mjc-ermont/2011/README

Git avait dit de faire un README alors j'en ai fait un.
JeanMouloude (@lucas95)

(fallait le modifier pour le commit)

N'oublions pas de dire que la reponse est 42 mon cher Jean !
Je ne sais quoi dire ...
