mjc-ermont/2011/Electronique/Modulation FSK/Liste composants.txt

Resistances :
	- 2 x 5.1K
	- 1 x 200
	- 1 x 50K
	- 2 Resistance de valeur inconnue

Condensateurs :
	- 1 x 10µ Polarisé
	- 2 x 1µ
	- 1 Condensateur de valeur inconnue

- XR2206
