mjc-ermont/2011/Administratif/Schema avion/schema.pdf

## Schéma de l'avion

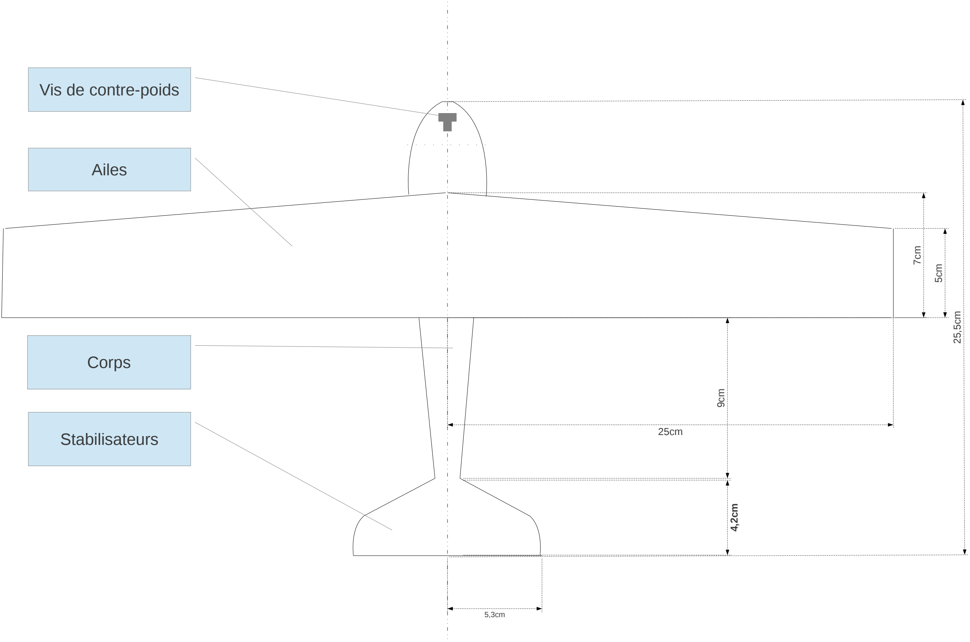
[picture p38: figure]
Vis de contre-poids; Ailes; Stabilisateurs; Corps
