mjc-ermont/2011/Programmation/Codes fonctionnels/Logger21/LSerie/Exemple/serialtest.jpg

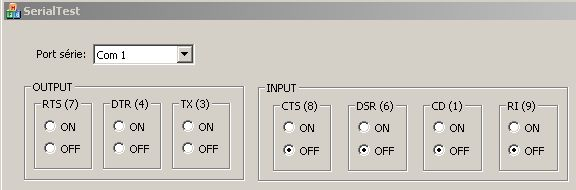
Programmation/Codes fonctionnels/Logger21/LSerie/Exemple/serialtest.jpg
