mjc-ermont/2011/Meca/Modélisation nacelle SolidWorks/Maintient Pile Arduino/Assemblage Pile.SLDASM

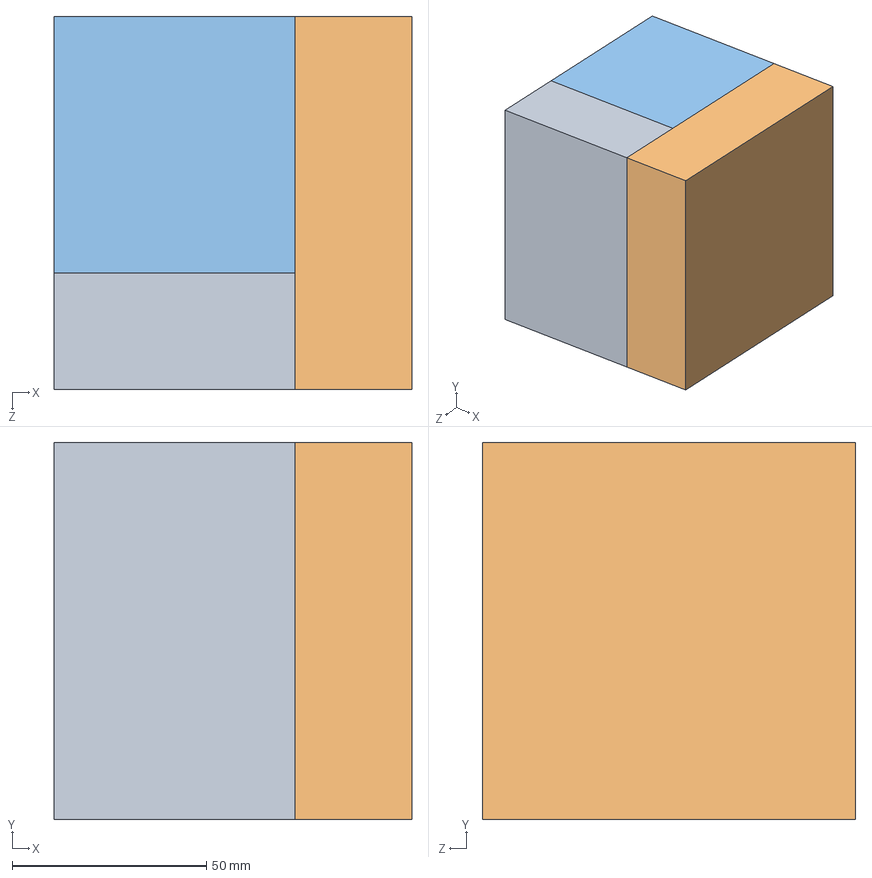
[picture p40: CAD file, 2013-04-06]
Meca/Modélisation nacelle SolidWorks/Maintient Pile Arduino/Assemblage Pile.SLDASM
92.0 x 97.0 x 96.0 mm
Plaque1
Plaque2
Bouchon
