mjc-ermont/2011/Meca/Modélisation nacelle SolidWorks/Assemblage.SLDASM

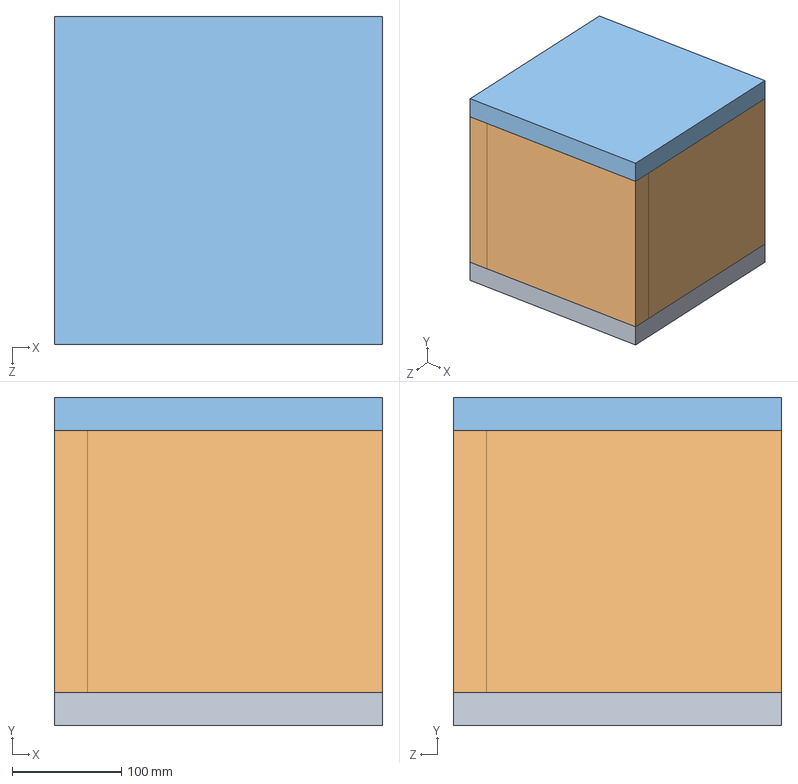
[picture p41: CAD file, 2013-04-07]
Meca/Modélisation nacelle SolidWorks/Assemblage.SLDASM
300.0 x 300.0 x 300.0 mm
Plaque inférieure
Plaque latérale x 4
Plaque supérieure
Plaque1
Plaque2
Bouchon
Arduino
Kiwi
Bouchon_kiwi
Plaque1_kiwi
Plaque2_kiwi
