mjc-ermont/2011/Meca/Modélisation nacelle SolidWorks/Maintient pile kiwi/Assemblage_kiwi.SLDASM

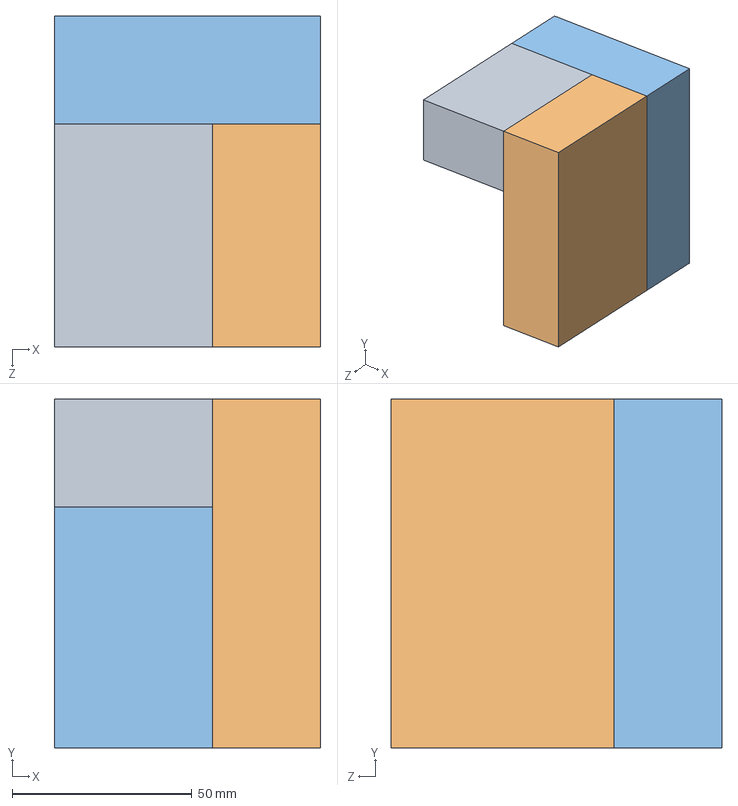
[picture p42: CAD file, 2013-04-06]
Meca/Modélisation nacelle SolidWorks/Maintient pile kiwi/Assemblage_kiwi.SLDASM
74.0 x 97.0 x 92.0 mm
Bouchon_kiwi
Plaque1_kiwi
Plaque2_kiwi
