mjc-ermont/2011/Meca/Modélisation nacelle SolidWorks/Maintient Pile Arduino/Plaque1.SLDPRT

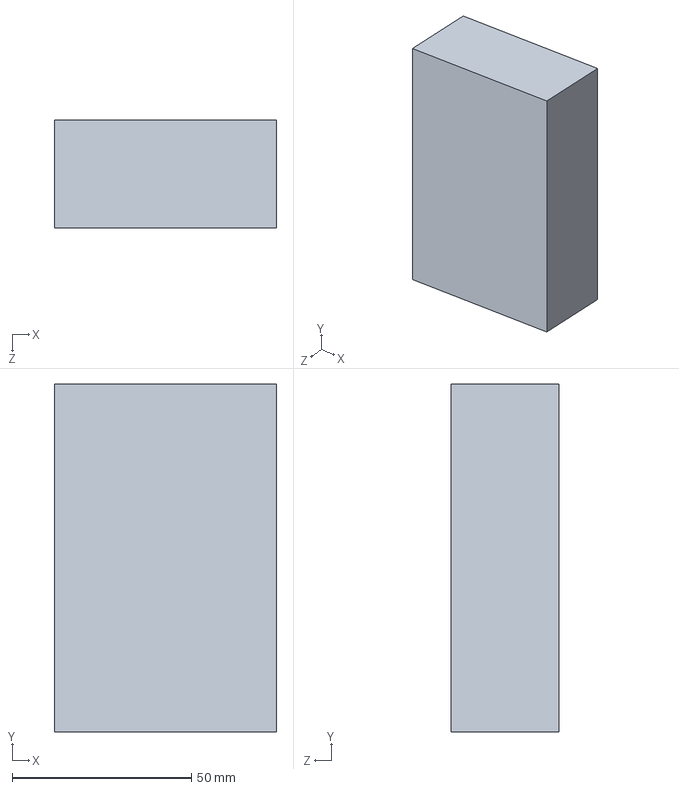
[picture p43: CAD file, 2013-04-06]
Meca/Modélisation nacelle SolidWorks/Maintient Pile Arduino/Plaque1.SLDPRT
62.0 x 97.0 x 30.0 mm
