mjc-ermont/2011/Meca/Modélisation nacelle SolidWorks/Maintient pile kiwi/Plaque2_kiwi.SLDPRT

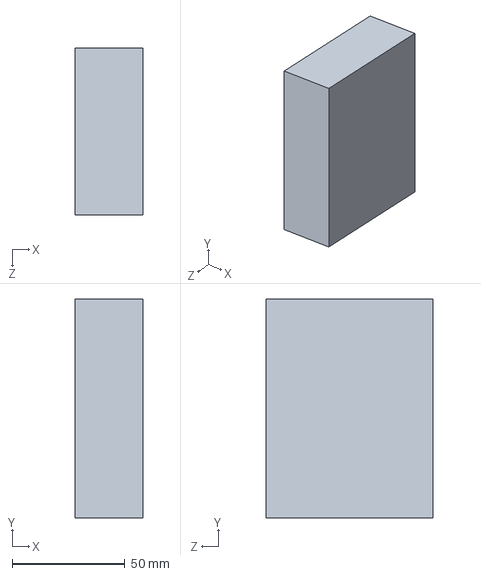
[picture p44: CAD file, 2013-04-06]
Meca/Modélisation nacelle SolidWorks/Maintient pile kiwi/Plaque2_kiwi.SLDPRT
30.0 x 97.0 x 74.0 mm
