mjc-ermont/2011/Meca/Modélisation nacelle SolidWorks/Plaque latérale.SLDPRT

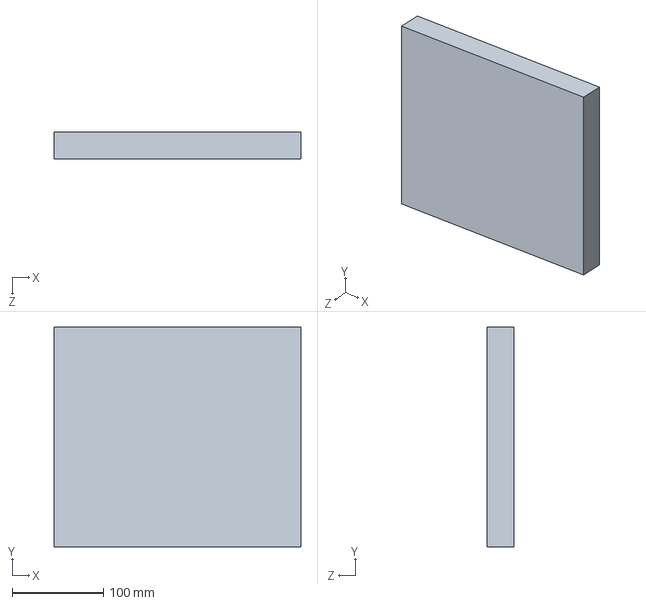
[picture p45: CAD file, 2013-04-07]
Meca/Modélisation nacelle SolidWorks/Plaque latérale.SLDPRT
270.0 x 240.0 x 30.0 mm
