mjc-ermont/2011/Meca/Modélisation nacelle SolidWorks/Maintient pile kiwi/Bouchon_kiwi.SLDPRT

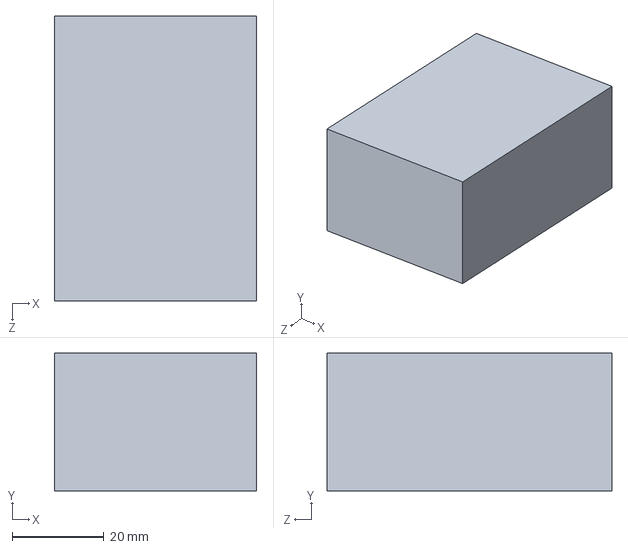
[picture p46: CAD file, 2013-04-06]
Meca/Modélisation nacelle SolidWorks/Maintient pile kiwi/Bouchon_kiwi.SLDPRT
44.0 x 30.0 x 62.0 mm
