mjc-ermont/2011/Meca/Modélisation nacelle SolidWorks/Plaque supérieure.SLDPRT

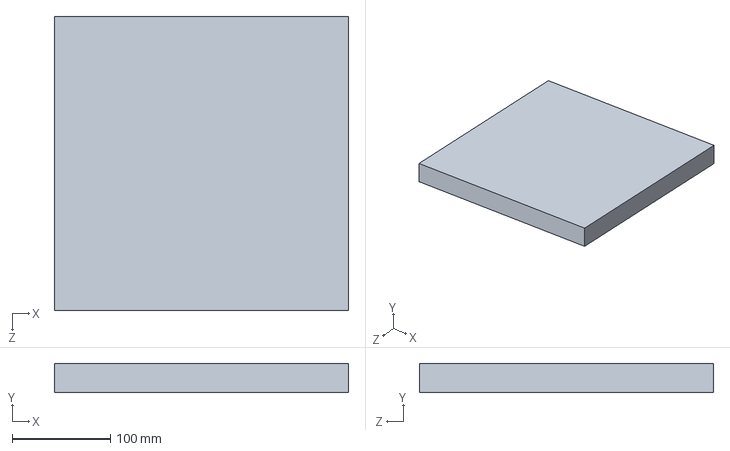
[picture p47: CAD file, 2013-04-07]
Meca/Modélisation nacelle SolidWorks/Plaque supérieure.SLDPRT
300.0 x 30.0 x 300.0 mm
