mjc-ermont/2011/Meca/Modélisation nacelle SolidWorks/Maintient Pile Arduino/Bouchon.SLDPRT

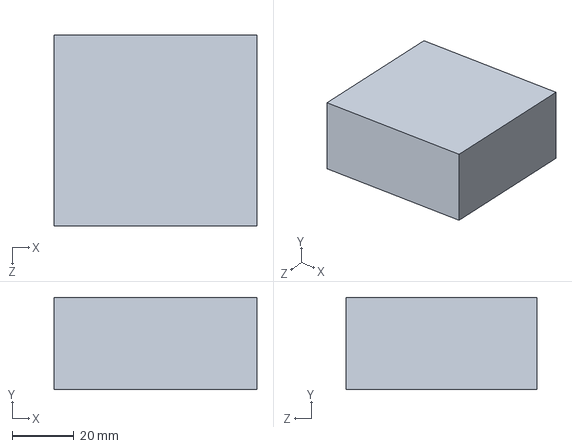
[picture p48: CAD file, 2013-04-06]
Meca/Modélisation nacelle SolidWorks/Maintient Pile Arduino/Bouchon.SLDPRT
66.0 x 30.0 x 62.0 mm
