mjc-ermont/2011/Meca/Modélisation nacelle SolidWorks/Kiwi.SLDPRT

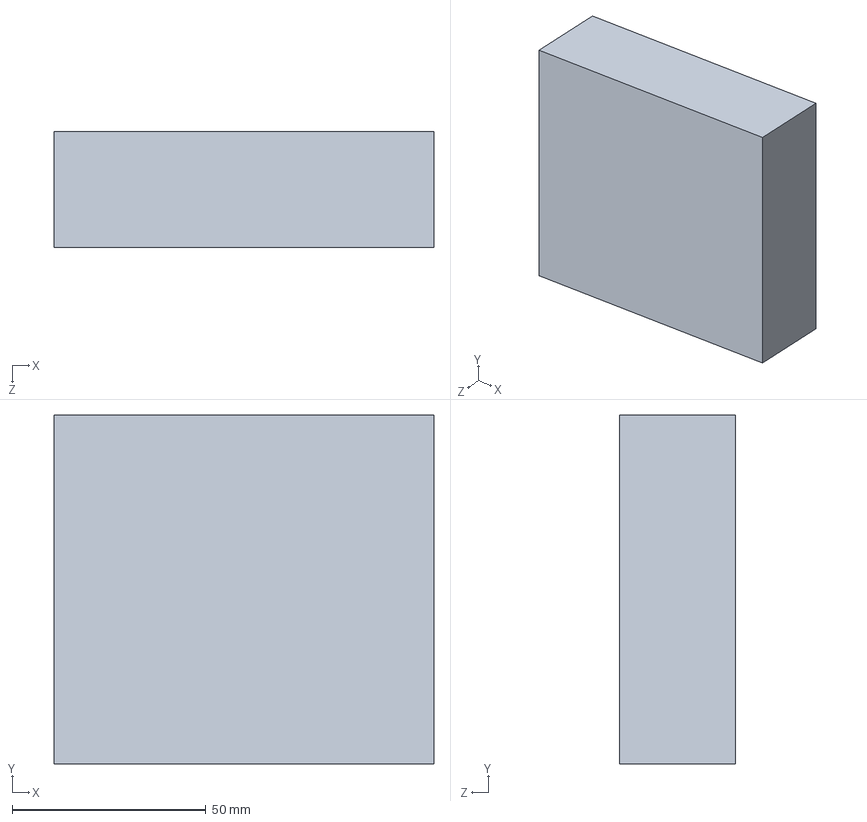
[picture p49: CAD file, 2013-04-06]
Meca/Modélisation nacelle SolidWorks/Kiwi.SLDPRT
98.0 x 90.0 x 30.0 mm
