mjc-ermont/2011/Meca/Modélisation nacelle SolidWorks/Maintient Pile Arduino/Plaque2.SLDPRT

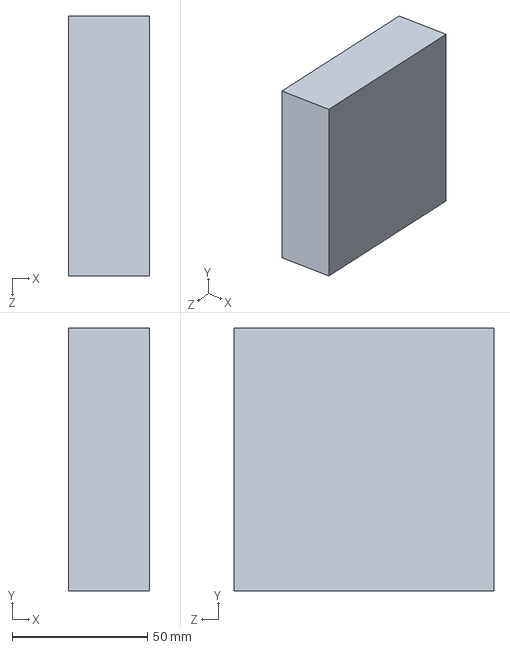
[picture p50: CAD file, 2013-04-06]
Meca/Modélisation nacelle SolidWorks/Maintient Pile Arduino/Plaque2.SLDPRT
30.0 x 97.0 x 96.0 mm
