mjc-ermont/2011/Meca/Modélisation nacelle SolidWorks/Arduino.SLDPRT

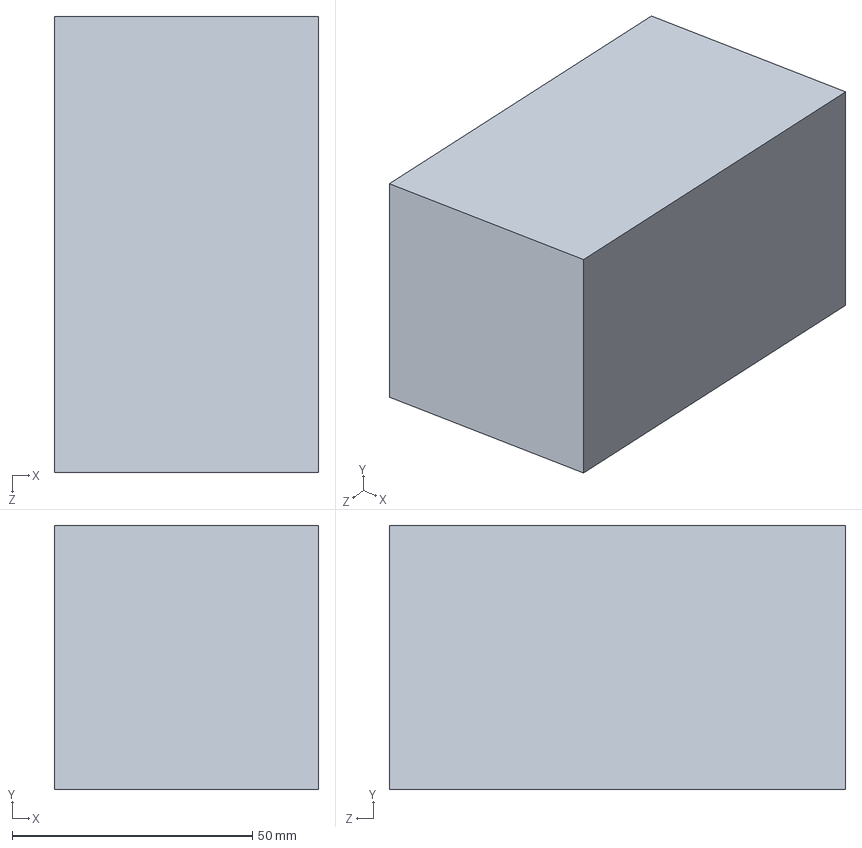
[picture p51: CAD file, 2013-04-06]
Meca/Modélisation nacelle SolidWorks/Arduino.SLDPRT
55.0 x 55.0 x 95.0 mm
