mjc-ermont/2011/(list of files, cad)

Other CAD files:
Meca/Modélisation nacelle SolidWorks/Plaque inférieure.SLDPRT
