mjc-ermont/2011/Programmation/Codes fonctionnels/Logger21/LSerie/Exemple/Release/BuildLog.htm

Build Log

| | ------- Build started: Project: SerialTest, Configuration: Release|Win32 -------

Command Lines

Creating temporary file "e:\Mes documents\Alex\Informatique\SerialTest\Release\RSP000003.rsp" with contents
[
/O2 /D "WIN32" /D "_WINDOWS" /D "NDEBUG" /D "_AFXDLL" /D "_MBCS" /FD /EHsc /MD /GS /Zc:wchar_t /Yu"stdafx.h" /Fp"Release/SerialTest.pch" /Fo"Release/" /Fd"Release/vc70.pdb" /W3 /c /Wp64 /Zi /TP
".\SerialTestDlg.cpp"
".\SerialTest.cpp"
".\LSerie.cpp"
]
Creating command line "cl.exe @"e:\Mes documents\Alex\Informatique\SerialTest\Release\RSP000003.rsp" /nologo"
Creating temporary file "e:\Mes documents\Alex\Informatique\SerialTest\Release\RSP000004.rsp" with contents
[
/O2 /D "WIN32" /D "_WINDOWS" /D "NDEBUG" /D "_AFXDLL" /D "_MBCS" /FD /EHsc /MD /GS /Zc:wchar_t /Yc"stdafx.h" /Fp"Release/SerialTest.pch" /Fo"Release/" /Fd"Release/vc70.pdb" /W3 /c /Wp64 /Zi /TP
".\Stdafx.cpp"
]
Creating command line "cl.exe @"e:\Mes documents\Alex\Informatique\SerialTest\Release\RSP000004.rsp" /nologo"
Creating command line "rc.exe /d "NDEBUG" /d "_AFXDLL" /l 0x40c /I "Release" /fo"Release/SerialTest.res" ".\SerialTest.rc""
Creating temporary file "e:\Mes documents\Alex\Informatique\SerialTest\Release\RSP000005.rsp" with contents
[
/OUT:"Release/SerialTest.exe" /INCREMENTAL:NO /NOLOGO /DEBUG /PDB:"Release/SerialTest.pdb" /SUBSYSTEM:WINDOWS /OPT:REF /OPT:ICF /MACHINE:X86
".\Release\LSerie.obj"
".\Release\SerialTest.obj"
".\Release\SerialTestDlg.obj"
".\Release\Stdafx.obj"
".\Release\SerialTest.res"
]
Creating command line "link.exe @"e:\Mes documents\Alex\Informatique\SerialTest\Release\RSP000005.rsp""

Output Window

| | Compiling... Stdafx.cpp Compiling... SerialTestDlg.cpp SerialTest.cpp LSerie.cpp Generating Code... Compiling resources... Linking... LINK : warning LNK4089: all references to 'OLEAUT32.dll' discarded by /OPT:REF

Results

| | Build log was saved at "file://e:\Mes documents\Alex\Informatique\SerialTest\Release\BuildLog.htm" SerialTest - 0 error(s), 1 warning(s)
