mjc-ermont/2011/Docs/hyt371-scale-pin-assignment.pdf

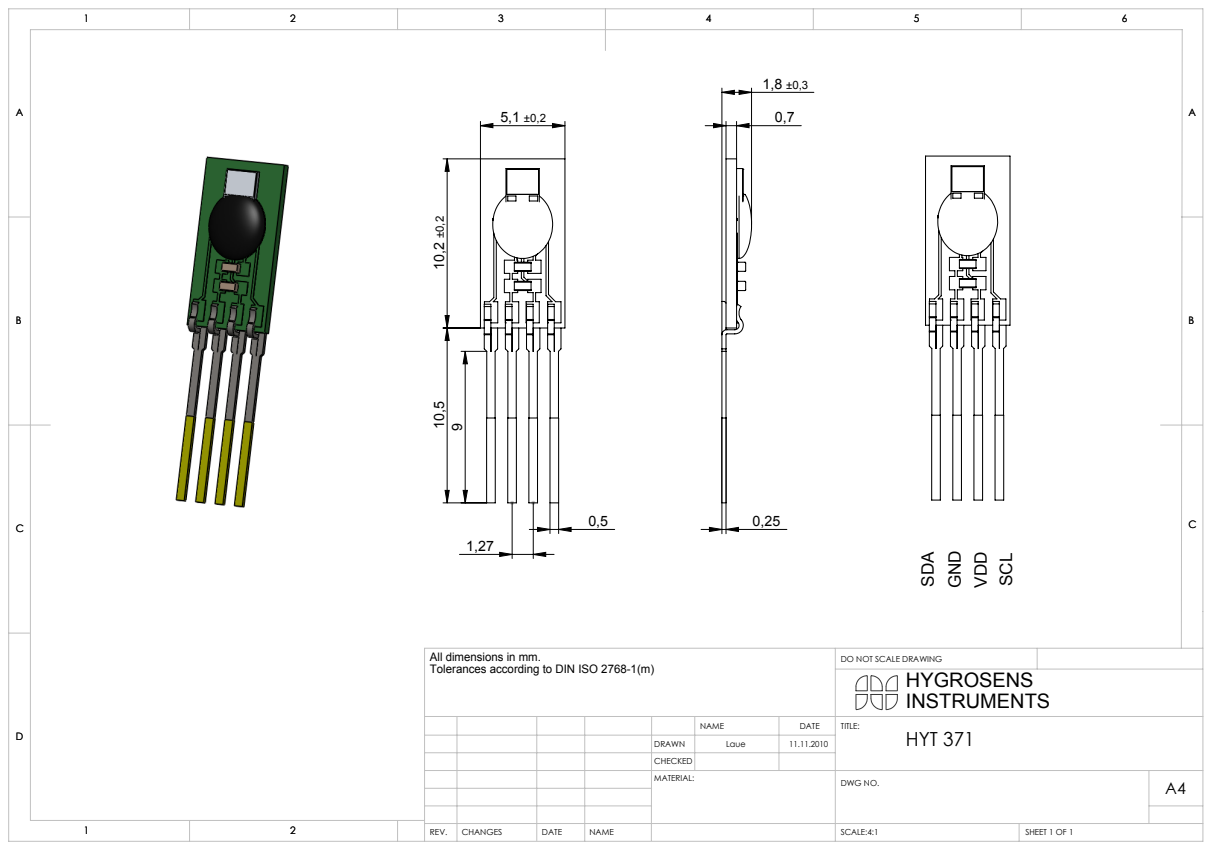
[picture p52: page 1]
SCALE:4:1; SHEET 1 OF 1

All dimensions in mm.
Tolerances according to DIN ISO 2768-1(m)

DO NOT SCALE DRAWING
HYGROSENS
INSTRUMENTS

NAME | DATE | TITLE: HYT 371

DRAWN | Laue | 11.11.2010
CHECKED
MATERIAL: | DWG NO. | A4
