mjc-ermont/2011/Electronique/arduino-sensor-shield/microSD_Shield-v13 Schematic.pdf

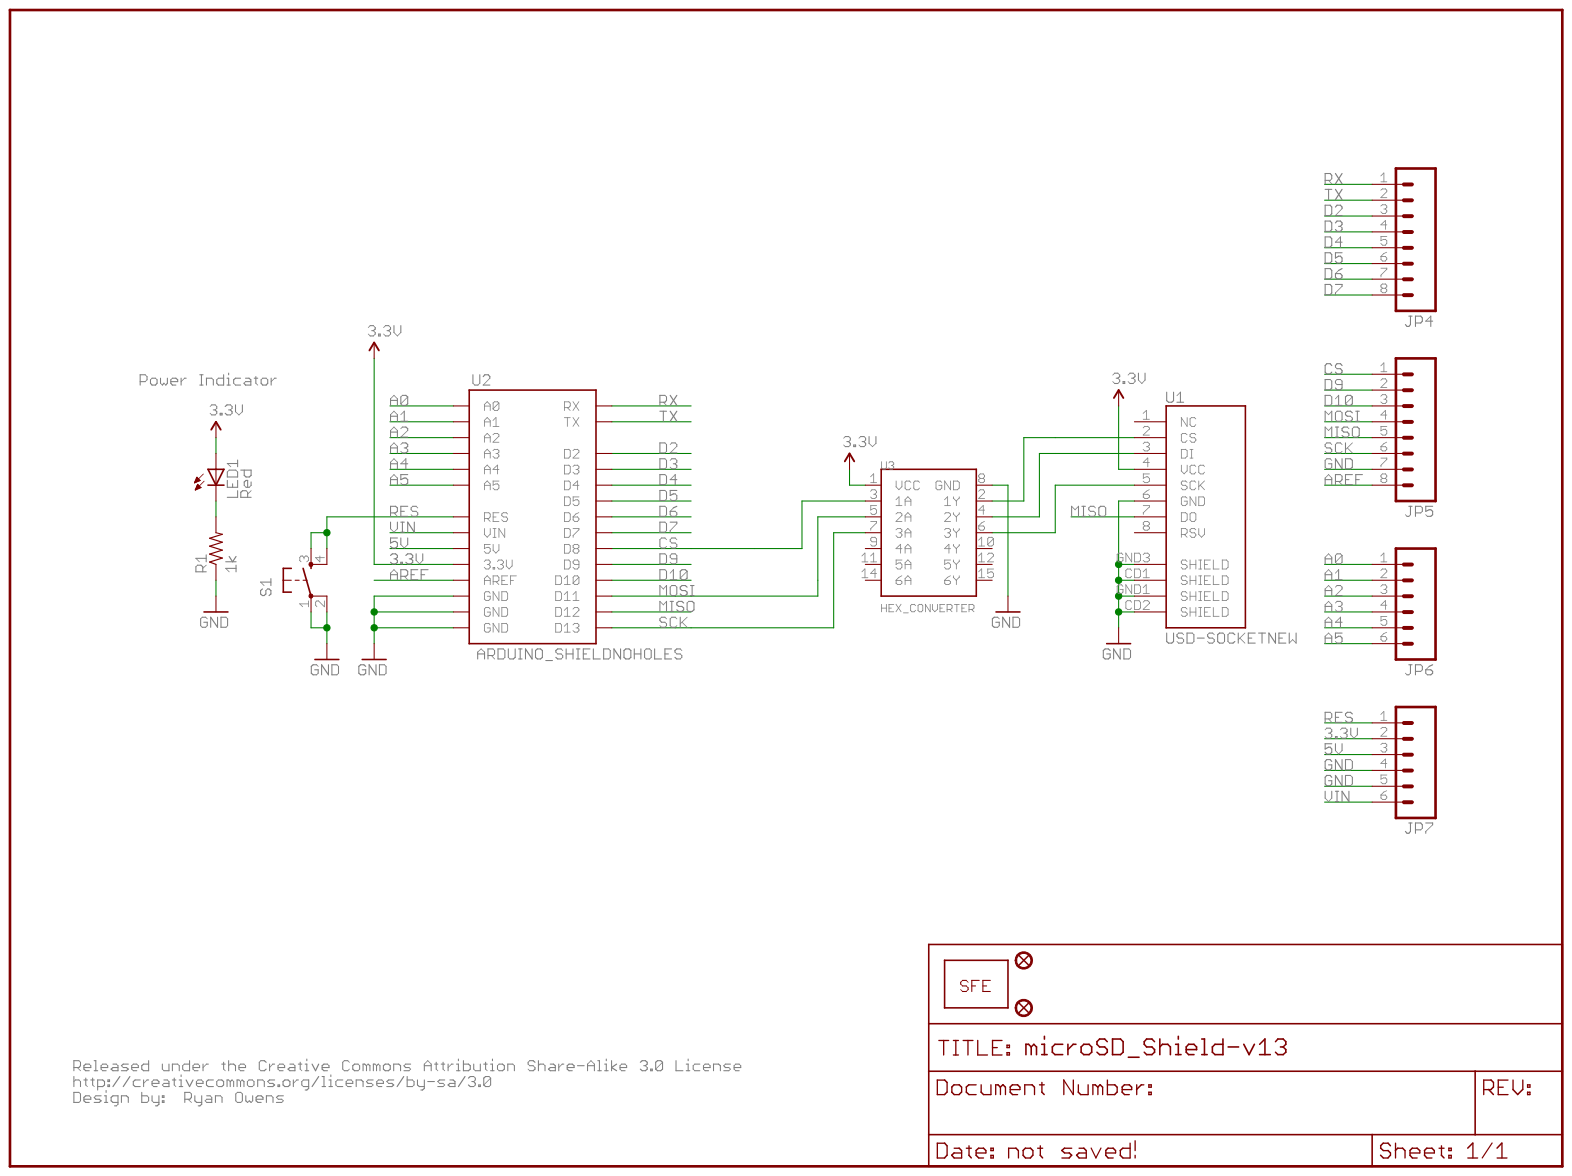
[picture p53: page 1]
