mjc-ermont/2011/Electronique/Pression/pression.sch

## KiCad design Electronique/Pression/pression.sch (2012-03-31)

Schematic: pression.sch

Parts:
10k: R
+9V05, +9V07: VCC
CAPT_TEMP: R
GND: VSS
GND06, GND08: GND
MPX~2200AP1: CONN_4
POT1: 1M
POT2: 20k
POT3: 4.7k
R1: 4.7k
R2: 3.3k
R3: 680k
R5: 1.5k
R6: 10k
U1: LM324
