mjc-ermont/2011/Electronique/arduino-sensor-shield/arduino-sensors-shield.sch

## KiCad design Electronique/arduino-sensor-shield/arduino-sensors-shield.sch (2012-12-24)

Schematic: arduino-sensors-shield.sch

Parts:
C30, C50: C
D5: LED
MCP3002: CONN_4X2
P1, P2, P3, P8, P50, P51: CONN_3
P5: CONN_8
P31: ADXL345
P33: HYT-371
R1, R2, R3, R5, R31, R32: R
SHIELD_REV_V31: ARDUINO_SHIELD
U1: 4050
