mjc-ermont/2011/Electronique/fsk-alim10v-shield/fsk-alim10v-shield.sch

## KiCad design Electronique/fsk-alim10v-shield/fsk-alim10v-shield.sch (2012-12-27)

Schematic: fsk-alim10v-shield.sch

Parts:
C1, C2: CP
C3, C4, C5: C
D1: DIODE
D2: LED
K1: CONN_3
L1, L2: INDUCTOR
P1, P2: CONN_2
P3: BNC
R1, R2, R3, R4, R5: R
RV1, RV2, RV3: POT
SHIELD1: ARDUINO_SHIELD
U1: 7805
U2: XR2206
