mjc-ermont/2011/Electronique/Modulation FSK/Carte/Shield FSK.sch

## KiCad design Electronique/Modulation FSK/Carte/Shield FSK.sch (2012-12-27, an earlier design)

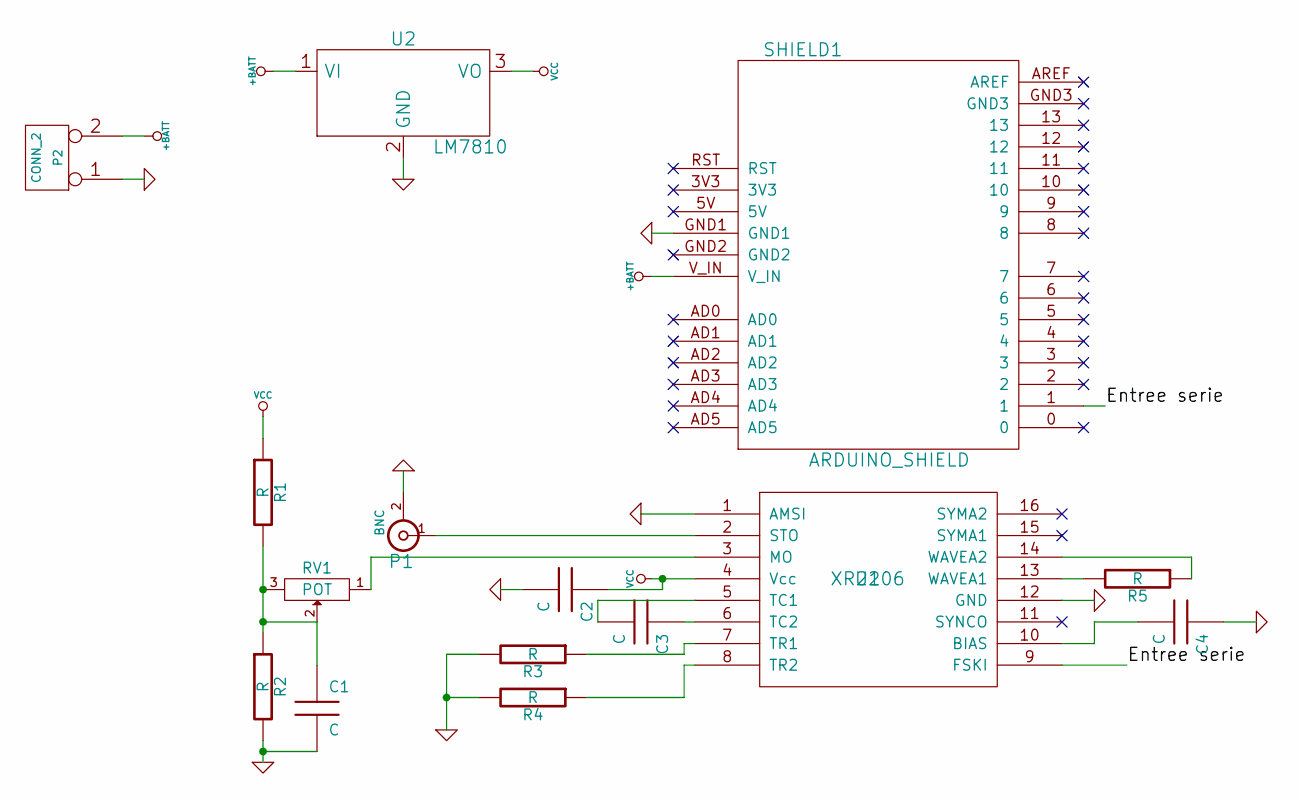
[picture p54: schematic Shield FSK.sch]

Parts:
C1, C2, C3, C4: C
P1: BNC
P2: CONN_2
R1, R2, R3, R4, R5: R
RV1: POT
SHIELD1: ARDUINO_SHIELD
U1: XR2206
U2: LM7810

Connections:
+BATT: P2.2 (PM), SHIELD1.V_IN, U2.1 (VI)
Entree serie: SHIELD1.1, U1.9 (FSKI)
GND: C1.2, C2.2, C4.1, P1.2 (Ext), P2.1, R2.2, R3.2, R4.2, SHIELD1.GND1, U1.1 (AMSI), U1.12 (GND), U2.2 (GND)
unnamed: C1.1, R1.2, R2.1, RV1.2, RV1.3
unnamed: C3.1, U1.6 (TC2)
unnamed: C3.2, U1.5 (TC1)
unnamed: C4.2, U1.10 (BIAS)
unnamed: P1.1 (In), U1.2 (STO)
unnamed: R3.1, U1.7 (TR1)
unnamed: R4.1, U1.8 (TR2)
unnamed: R5.1, U1.14 (WAVEA2)
unnamed: R5.2, U1.13 (WAVEA1)
unnamed: RV1.1, U1.3 (MO)
VCC: C2.1, R1.1, U1.4 (Vcc), U2.3 (VO)
