mjc-ermont/2011/Programmation/Fragments de code/Classes/Define.h

/***********************************************************************************
 *************************         Id des capteurs         *************************
 ***********************************************************************************/
 
#define ID_GPS                   "00"
   #define ID_GPS_LATANGLE         "00"
   #define ID_GPS_LATMINUTE        "01"
   #define ID_GPS_LONGANGLE        2                 //--->A remplacer par Arthur
   #define ID_GPS_LONGMINUTE       3
   #define ID_GPS_VITESSE          4
   #define ID_GPS_HEURE            5
   #define ID_GPS_VITESSE          6

#define ID_CAPPRESSION           "01"
   #define ID_CAPPRESSION_PRESSION "00"

/***********************************************************************************
 *************************               Trame             *************************
 ***********************************************************************************/
 
 #define SIZE_VALUE 7

/***********************************************************************************
 ***********************************************************************************
 ***********************************************************************************/
