mjc-ermont/2011/Programmation/Fragments de code/Accelerometre/Accelerometre.ino

/*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
 * Revision History
 * 
 * Date  By What
 * 20100515 TJS Initial Creation 
 * 20100524 TJS Modified to run with Kevin Stevenard's driver
 */
#include "Wire.h"
#include "ADXL345.h"

ADXL345 Accel;

void setup(){
  Serial.begin(57600);
  delay(1);
  Wire.begin();
  delay(1);
  Serial.println("Here");
  Accel.set_bw(ADXL345_BW_12);
  Accel.powerOn();
  Serial.print("BW_OK? ");
  Serial.println(Accel.status, DEC);
  delay(1000);
}

void loop(){
  int i;
  double acc_data[3];
  Accel.get_Gxyz(acc_data);
  if(Accel.status){
    float length = 0.;
    for(i = 0; i < 3; i++){
      length += (float)acc_data[i] * (float)acc_data[i];
      //Serial.print(acc_data[i]);
      //Serial.print(" ");
    }
    length = sqrt(length);
    Serial.print(length);
    Serial.println("");
    delay(40);
  }
  else{
    Serial.println("ERROR: ADXL345 data read error");
  }
}
