mjc-ermont/2011/Programmation/Codes fonctionnels/Arduino/capteur_analog.cpp

#include "capteur_analog.h"

CapteurAnalog::CapteurAnalog(byte id, int pin) : Capteur::Capteur(id, 1){
  _pin = pin;
}

bool CapteurAnalog::init(){
}

bool CapteurAnalog::refresh(){
  itoa(analogRead(_pin), _val[0], 10);
}
