mjc-ermont/2011/Programmation/Codes fonctionnels/Arduino/temp.h

#ifndef TEMP_INCLUDED
#define TEMP_INCLUDED

#include <Arduino.h>
#include "capteur_analog.h"

class Temp : public CapteurAnalog{
public:
	Temp(byte id, int pin);
	bool init(); // Initialisation du capteur
	bool refresh();  // Recuperation de la temperature
        //void getTrame(); // Envoi de la trame
};

#endif
