mjc-ermont/2011/(commit log)

2011-11-25 Modifications de quelques liens dans le tableau de la description
2011-11-26 Description projet/Description.tex : - Ajout de l'avion et de son lanceur en 9ème priorité - Correction d'une faute d'encodage dans la partie contraintes (le ' de l'exterieur n'aparaissait pas).
2011-11-26 Description.tex : - Ajout du poids d'alignement de la camera dans les contraintes. - correction d'une autre faute d'encodage dans la description du contenu du ballon (encore le ' de l'horizon).
2011-11-27 Description projet/Description.tex : - Ajout de contraintes (GPS et capteur de température interieure) - Ajout d'une partie planning dans la partir preparation$ - Renommage de l'annexe shéma en synop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
2011-11-27 Description projet/Description.tex - Ajout ddu lien de la datasheet du capteur de CO2
2011-11-28 Description projet/Description.tex : - Ajout d'une partie choix des matériaux
2011-12-02 Ajout de la datasheet du recepteur GPS (Docs/GPS.pdf)
2011-12-03 Description projet/Description.tex : - Ajout du lien vers la datasheet du capteur de CO2 - Ajout du nom du constructeur du modula accélérometre
2011-12-03 - Ajout d'un fichier contenant la liste des taches a réaliser (Planning/Liste taches.txt)
2011-12-06 Description projet/Description.tex : - Mise a jou du GPS dans la liste des composants - Ajout du polystyrène extrudé dans la liste des matériaux
2011-12-06 - Ajout d'un .gitignore qui exclut les fichiers de compilation LaTex, soit : - Description projet/Description.aux - Description projet/Description.bbl - Description projet/Description.blg - Descripti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
2011-12-06 Ajout du projet kiCAD de la carte electronique (Electronique/Carte Arduino/Carte Arduino.pro)
2011-12-09 Electronique/Carte Arduino/Carte Arduino.sch : - Ajout du capteur de température
    [Carte Arduino.sch]
2011-12-09 Electronique/Carte Arduino/Carte Arduino.sch : - Ajout du capteur de pression
    [Carte Arduino.sch]
2011-12-10 Description projet/Description.tex : - Ajout des spécifications du polystyrène extrudé
2011-12-10 Electronique/Carte Arduino/Carte Arduino.pro : - Ajout des capteur de pression et de temperature interne
    [Carte Arduino.sch]
2011-12-10 Electronique/Carte Arduino/Carte Arduino.sch : - Ajout des composants I²C (Gyroscope, Acceleromètre, Humidité)
    [Carte Arduino.sch]
2011-12-10 Planning/planning.gan : - Fusion de "Tests electroniques + programmation" et de "test electroniques" - renommage de "Programmation episode 1" en "Programmation (Capteurs Analogiques + Trasmission)"
2011-12-11 Ajout de la llibrairie kiCAD contenant le schéma de l'arduino mini (Electronique/Librairies kiCAD/Arduino.lib)
    [Carte Arduino.sch]
2011-12-11 Electronique/Carte Arduino/Carte Arduino.sch : - Ajout de l'Arduino
    Electronique/Librairies kiCAD/Arduino.lib :
    - Finition de la modélisation du schéma de l'arduino mini
    [Carte Arduino.sch]
2011-12-12 Electronique/Carte Arduino/Carte Arduino.sch : - Ajout de labels sur l'Arduino
    [Carte Arduino.sch]
2011-12-12 Electronique/Carte Arduino/Carte Arduino.sch : - Ajout des connexions de l'accéléromètre
    [Carte Arduino.sch]
2011-12-12 Electronique/Carte Arduino/Carte Arduino.sch : - Ajout des connecteurs pour les capteurs de Co2 et de CH4
    [Carte Arduino.sch]
2011-12-13 Electronique/Carte Arduino/Carte Arduino.sch : - Ajout des connexions des pins des capteurs de CO2 et de CH4
    [Carte Arduino.sch]
2011-12-13 Electronique/Carte Arduino/Carte Arduino.sch : - Implémentation du GPS
    [Carte Arduino.sch]
2011-12-17 Ajout d'un nouveau fichier PDF contenant seulement les spécifications du protocole TAIP pour le module GPS (Docs/TAIP.pdf)
2011-12-17 Electronique/Carte Arduino/Carte Arduino.sch : - Ajout du Backup power sur le GPS
    [Carte Arduino.sch]
2011-12-17 Normalement, si le fichier save.log existe, il utillise la fonction open pour le charger ...
2011-12-17 Electronique/Carte Arduino/Carte Arduino.sch : - Implémentation des thermistances avec linéarisation
    [Carte Arduino.sch]
2011-12-17 Ajout d'un sous-fenêtre "Tableau de bord" (sans connectivité)
2011-12-18 Programmation/logger/Donnees.cpp : - Ajout De la vitesse verticale et horizontale dans le tableau
2011-12-18 Ajout d'un .gitignore qui enleve les fichiers de sauvegrade kicad du depot.
2011-12-18 Ajout de l'hygrométrie interieure et exterieure au tableau (ben oui l'hygromètre ne faisait que la température ^^ : s'il n'y en a qu'un des deux, ne pas toucher ...
2011-12-19 Electronique/Carte Arduino/Carte Arduino.sch : - Implémentation des capteurs de pression
    [Carte Arduino.sch]
2011-12-20 Ajout d'un fragment de code pour le decodage des trames séries émises par le module GPS (Fragments de code/GPS/TAIP.C)
2011-12-20 Ajout d'un bout de code pour l'implémentation du Gyroscope (Programmation/Fragments de code/Gyroscope/L3G4200D Arduino Library.pde)
2011-12-20 Ajout de bouts de codes pour l'implémentation de l'accéléromètre (Programmation/Fragments de code/Acceleromètre)
2011-12-21 Ajout d'un bout de code pour l'implémentation de l'hygromètre (Programmation/Fragments de code/Hygromètre/HYT371.pde)
2011-12-22 Description projet/description.tex : Ajout de liens vers la doc du GPS et vers le planning
2011-12-31 Ajout d'un dossier "Administratif" qui contient le dossier de projet (Administratif/Dossier_de_projet_2011-2012.xls)
    [Dossier_de_projet_2011-2012.xls]
2012-01-07 Programmation/Codes fonctionnels/Code_GPS_pde/Code_GPS_pde.pde : - Ajout de la requete TAIP
2012-01-07 Programmation/Codes fonctionnels/GPS/GPS.pde : - Changement du type de la variable rxbyte dans la fonction loop en char pour l'affichage des caractères
2012-01-07 Programmation/Codes fonctionnels/GPS/GPS.pde : - Mise en forme des affichages de debogage
2012-01-20 Administratif/Dossier_de_projet_2011-2012.xls : - Suite de la complétition de l'onglet 2 - Définition
    [Dossier_de_projet_2011-2012.xls]
2012-01-21 Ajout de la lecture du températuremètre. Designed by Mouloude
2012-01-28 Ajout de la librairie permettant l'utilisation du GPS (/Programmation/Librairies/TinyGPS/)
2012-01-28 Ajout du système de sauvegarde sur la Carte SD of the dead.
2012-01-31 Revert "Ajout du systÃ¨me de sauvegarde sur la Carte SD of the dead."
    This reverts commit 693f9e0d4e2c231ea3e13ac3ce6ebc43ff3a73b3.
    [lecture.pde]
2012-02-04 J'aime les frites
2012-02-04 On recommence tout parce-que on aime ça :D
2012-02-04 Ajout de la classe line et du design
2012-02-04 Programmation/Codes fonctionnels/GPS2/GPS2.pde : - Ajout de la conversion en ° et minutes
2012-02-05 Administratif/Dossier_de_projet_2011-2012.xls : - Remplissage de la fiche technique, reste a faire : - Calcul d'autonomie - description de la trame - Demande de dérogation
    [Dossier_de_projet_2011-2012.xls]
2012-02-05 Administratif/Dossier_de_projet_2011-2012.xls : - Remplissage de la demande de dérogation pour l'avion
    [Dossier_de_projet_2011-2012.xls]
2012-02-11 Pas grand chose, juste une sauvegarde (titre des onglets ^^)
2012-02-11 Fonctionnel (enregistre / charge le fichier)
2012-02-11 Ajout de docs concernant la modulation externe du kiwsi
2012-02-11 J'ai juste ajouté la base de donné
2012-02-13 Enregistre maintenant dans la base de données mysql (---> Base de données initiales join ...) + ajout de la méthode append à la classe "FenPrinicipale"
2012-02-13 Ajotu d'une doc ur une composant permettant la modulation esxterne (Docs/XR2206V1.pdf)
2012-03-08 Ajout de fichiers pour la modulation FSK
    [Calculs Resistances.xlsx]
2012-03-10 Electronique/Modulation FSK/Calculs Resistances.xlsx: - Ajout des valeur normaliséers de resistance
    [Calculs Resistances.xlsx]
2012-03-10 Ajout du schéma du capteur de pression. Designed by Mouloude.
    [pression.sch]
2012-03-10 Ajout de la sématique pour le modulateur FSK
    [Shield FSK.sch]
2012-03-10 Mise a jour de la liste des composants pour la modulation FSK
2012-03-10 Ajout de la liste des composants
2012-03-10 Calcul des resistance pour la modulation FSK
    [Calculs Resistances.xlsx]
2012-03-10 Finition de la scématique du shield FSK.
    [Dossier_de_projet_2011-2012.xls]
2012-03-10 Finition du schéma du capteur de pression
2012-03-17 Ajout de la librairie Qwt
2012-03-17 Ajout de la lib au projet J'ajoute directement les sources dans le projet parce-que ca me fait chier de le compiler à chaques fois, donc c'est juste un peu long à compiler la première fois ... xD
2012-03-21 On commence l'association enpreintes pour le shield FSK
    [Shield FSK.sch]
2012-03-22 Et hop, au pas de course, on ajoute les libs pour le shield arduino
2012-03-22 Carte FSK routée !!!
    [Shield FSK.brd, Shield FSK.sch]
2012-03-23 On améliore un peu le routage
    [Shield FSK.sch]
2012-03-24 Et on reroute, on reroute, on reroute, on reroute, on reroute, on reroute, on reroute, on reroute, on reroute, on reroute, on reroute, on reroute, on reroute, on reroute, on reroute, on reroute, on r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
    [Shield FSK.brd, Shield FSK.sch]
2012-03-24 Commencement de la lecture du port série de la mort qui tue sa race. -> Ajout de la lib LSerie. -> Ajout de la classe Serial (because I am bilingue)
2012-03-31 Application de la nouvelle trame pour l'envoi des données GPS
    [Shield FSK.brd]
2012-03-31 Modifications de la shield pour les capteurs
    [pression.sch]
2012-04-07 GPS fonctionnel, manque plus que le checksum.
2012-04-09 Restructuration des dossiers (Rémi utilise les dossiers qui ont été crées au lieu de tout foutre a l'arrache dans le dossier prog !!!). Et restructuration du code pour lire les données du GPS (j'impl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
2012-04-14 Optimisation du code 1/? Lis les types de capteurs dans un fichier .ini
2012-04-14 Ajout de la vitesse
2012-04-26 Je sais plus ce que j'ai fait lol
2012-04-26 Ajout de l'altiude (qui marchotte a peu pres pas, ...)
2012-04-26 Ajout du multi thread
2012-05-05 Récupération de la trame série opérationnelle. Il ne reste plus qu'à la décoder.
    AWWWWWW YEAH
    au fait je suis 29ème à Prologin c'est super :)
2012-05-05 Modifications de l'architecture pour la récupérations des données. Devenue plus modulable (mais moins compréhensible mais on s'en fout) Quelques bugs mais rien de grave.
    Designed by Mouloude
    PS: Le code a Rémi il est pas beau, le mien est mieux bien :)
    [FenPrincipale.cpp, FenPrincipale.h, main.cpp]
2012-05-12 Programmation/Codes fonctionnels/GPS2/GPS2.ino : - Modification des id des capteurs et des valeutrs (commencent maintenant a 0 au lieu de 1 avant)
    Programmation/Codes fonctionnels/GPS2/trame.cpp :
    - Modification foireuse au niveau du checksum
2012-05-19 Mise en place du capteur de pression, il faudra l'étalonner.
    Sinon on a appris que la pression ne s'égalisait pas quand on mettait deux ballons, un gonflé et l'autre non, sur un tube de 1.5m de long.
    Et puis on a mangé des Granolas.
    Et puis on a joué à Minecraft. En plus ce type c'était vraiment un fou, il a fait une ferme à fer automatique.
    Ah oui et y'a un Easter egg quelque part.
    Jean Luc a demandé d'acheter plus de chose, Rémi lui a demandé de payer Minecraft. Anthelme propose qu'on achète un GPS, c'est Rémi qui a gagné.
    J'aime les cookies.
    Mon commit il est trop long of the dead.
    On a manger de granolas mais y en a deux qui en on manger 4 au lieu de 3 mais si tu aurais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
2012-05-26 Ajout du code pour le capteur de pression, et ça marche !!!
2012-05-26 Ce que j'ai fait aujourd'hui : J'ai modifié l'interface graphique toute moche de rémi. Maintenant elle est trop bien, en plus mon programme compile. Sinon j'ai mangé des Princes et des Barquettes au 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
    Bon bah voilà a+ tout le monde.
2012-05-26 Modifications de la GUI
    Notamment de l'affichage de l'historique.
2012-05-27 Viré la lib du gyroscope, qui ne servait plus a rien etant donné qu'on ne mettra pas de gyroscope
2012-05-27 J'ai fait un code tout Bôôôôw pour la carte avec tous les capteurs, pour l'instant il y a que le GPS, mais les autres vont pas tarder a venir
2012-05-27 Debug option + Affichage de l'historique
    Ajout d'un define DEBUG pour désactiver la liaison série et envoyer des
    valeurs aléatoires.
    Affichage de l'historique selon les capteurs.
2012-05-27 Ajout de l'heure
    Maintenant la GUI affiche l'heure :)
2012-05-27 Actualisation du tableau de bord
2012-05-27 Ajout d'un bouton Graphiques
    Et de messages de débug.
2012-05-27 Je voulais juste dire..
    .. que maintenant je sais utiliser la lib Qwt.
2012-05-28 Commençage de la gestion des graphiques.
2012-05-28 Affichage basique des graphiques
    çaaaaa maaaaarche !!
    AWWWWWWWWWWWWW YEAAAAAAAAAAH
2012-05-28 Rien de spécial.
    Quelques modifs sur l'affichage des graphs
2012-06-09 GPS marche, données extraites de la trame, reste plus que la mise en tableau a deboger.
2012-06-09 Renomage des capteurmetres On sais jamais
    [ADXL345.cpp, HYT371.pde, lecture.pde, sav_sd.ino]
2012-06-09 Renomage des capteurmetres
    On sais jamais (et pis j'ai compris le pb de la derniere fois)
    [ADXL345.cpp, HYT371.pde, lecture.pde, sav_sd.ino]
2012-06-09 Arboressance des classes
    Ca veut dire quoi "optional" ?
2012-06-10 Ajustement des structures, commentage, et déclaration de defines pour modulariser.
2012-06-10 Debogage des classes, faudra qu'on reparle de l'architecture ...
2012-06-23 Commit de ouf qui fait vraiment marcher of the world le GPS !!!
2012-06-29 La classe !!!
    J'aime vraiment pas ne rien mettre ici :s
    ░░░░░█░░░░▒▒▒▒▒▒▒▒▒▒▒▒░░▀▀▄░░░░
    ░░░░█░░░▒▒▒▒▒▒░░░░░░░░▒▒▒░░█░░░
    ░░░█░░░░░░▄██▀▄▄░░░░░▄▄▄░░░░█░░
    ░▄▀▒▄▄▄▒░█▀▀▀▀▄▄█░░░██▄▄█░░░░█░
    █░▒█▒▄░▀▄▄▄▀░░░░░░░░█░░░▒▒▒▒▒░█
    █░▒█░█▀▄▄░░░░░█▀░░░░▀▄░░▄▀▀▀▄▒█
    ░█░▀▄░█▄░█▀▄▄░▀░▀▀░▄▄▀░░░░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
2012-06-29 Implementation de la trame, mais la repetition a l'air de bugger ...
    [Arduino.ino, defines.h, gps.cpp, trame.cpp]
2012-06-30 Commitage inutille
    Commit de quelques trucs que j'avait pas save la dernière fois et d'un
    petit FIX (la classe !) de l'héritage (ca parrais énorme comme ca ...)
    █░▒█░█▀▄▄░░░░░█▀░░░░▀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
2012-06-30 Un petit commit parce-qu'on aime ca :)
    Comme je me rend compte que j'avance un peut et que c'est pas normal, je
    fais un ptit commit pour la route
    █░▒█░█▀▄▄░░░░░█▀░░░░▀▄░░▄▀▀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
2012-06-30 Petite commitation de fin
    Vivement Lucas, je manque d'imagination
    ░█░▀▄░█▄░█▀▄▄░▀░▀▀░▄▄▀░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
2012-06-30 Fait marcher toute la trame
2012-07-10 Reroutage de la carte FSK, ajout d'un régulateur de tension spécifique et d'un bornier
    [$savepcb.brd, Shield FSK.brd, Shield FSK.sch]
2012-08-21 / ‘README’
2012-09-15 Compatibilisation avec Arduino 1.0
2012-09-15 Tentative D'implmentation de l'accelero, mais il renvoie 0, peut tre un problemen de hard
    [ADXL345.cpp, Accelerometre.ino, Arduino.ino, accel.cpp, accel.h, defines.h]
2012-10-06 Ajout de la gestion de l'humidité
2012-10-13 Ajout de l'exemple du datalogger pour arduino 1.0
2012-10-13 Ajout de la fonctionnalite d'optimisation des graphiques (OMG JUSQU'A 10\!\!\!)
2012-10-13 Ajout de la gestion mieux bien de l'hygrometre, et debogage ...
2012-10-20 Modification du truc pour la pression et bidouillage de la reception
2012-10-20 Ajout de la datasheet de l'ADC
2012-10-20 Ajout des docs pour l'hygrometre et le pression
2012-10-20 Suppression des sauts de ligne dans la trame
2012-10-20 Gestion de la serie sur Linusque
2012-10-27 Suppression de la Bibliotheque de l'accelerometre dans le .h de l'humidité
2012-10-27 Tweaks pour faire marcher le capteur de pression
2012-10-27 Ajout de la pression dans le prog principal, TODO les pattes a mettre dans le constructeur
2012-11-10 Ajout de la temperature
2012-11-17 Supression du bug de pas MAJ de l'arduino
    [Arduino.ino]
2012-11-24 Création de l'éditeur de chronographie of the the dead Note 1: Faut avouer que c'est un logiciel de chronologie Note 2: Ca reste entre nous, le vrai nom du projet c'est chronoEdit alors qu'il s'appel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
2012-11-24 Remoulage de la gestion des donnees.
2012-12-08 ajout des fichiers administratif a remplir pour le 15 dec. 2012
    [Dossier_de_projet_2012-2013.xls, Fiche_de_club_2013.xls]
2012-12-08 remplissage des papiers ...
    [Dossier_de_projet_2012-2013.xls, Fiche_de_club_2013.xls]
2012-12-08 Ajout shield capteur kicad
    [shield_capteur.sch]
2012-12-08 Plein de choses utiles
2012-12-15 Finish des papiers a rendre aujourd'hui
    [Dossier_de_projet_2012-2013.xls, Fiche_de_club_2013.xls]
2012-12-15 update des de le pression et de la temperature
2012-12-15 ajout de la doc de l'accelero
2012-12-16 Resolvation a l'arrache of the dead de te fokin fok foker de sa race of the dead du truc qui faisait que l'accel demarrait pas ...
2012-12-21 Ajout du fichier vector.h pour gerer la queue de trames a envoyer
2012-12-21 Commence a faire la classe pour la sortie de la trame
2012-12-22 Debogage Accelero + Commencage d'implementer la nouvelle classe de sortie
2012-12-24 MAJ du shield capteur
    [$savepcb.brd, arduino-sensors-shield.brd, arduino-sensors-shield.sch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]
2012-12-25 Remise a jour de la partie administrative (parce que dans le dossier TODO on aurait pu mettre tout le projet ...)
    [Dossier_de_projet_2011-2012.xls, Dossier_de_projet_2012-2013.xls, Fiche_de_club_2013.xls]
2012-12-25 Bon, le planning, je pense qu'on peut le qualifier de blague maintenant hein !
2012-12-25 Je m'etonne moi même de n'avoir jamais viré ce fichier, le plus étonnant c'est qu'il est dans la partie codes fonctionnels ...
2012-12-25 Creation De la classe capteur
2012-12-25 Maintenant l'accelero herite de la classe capteur
2012-12-25 Commentage des defines
2012-12-25 Documentation de la classe de l'accelero
2012-12-25 Documentation de la fonction qui génere le checksum
2012-12-25 Documentation de la classe capeur
2012-12-25 Documentation de la classe GPS
2012-12-25 Documentation de la Classe Humidite
2012-12-25 Documentation de la classe Sortie
2012-12-25 Documentation de la classe pression
2012-12-25 Documentation de la classe Sortie Serie
2012-12-25 Documentation de la classe Temperature
2012-12-25 Refesation de l'indentation (Aller, rime riche interne !!!)
2012-12-25 Retypage de certaines variables pour economiser de la memoire
2012-12-25 Codage et implementation d'un système popre de debug
2012-12-26 Ajout d'une classe capteur analogique et implementation de celle ci
2012-12-26 Resolvation d'une erreur de compilation qui était cachée je sait pas par quoi ...
2012-12-26 Protection contre les inclusions infinies de la classe capteur
2012-12-26 Inclusion du debug.h dans la classe GPS pour pouvoir afficher des debugs a la con ...
2012-12-26 Ajout et utilisation de defines pour le capteur de pression et de temperature
2012-12-26 Protection contre les inclusions infinies de la classe de l'accelero
2012-12-26 Protection contre les inclusions infinies de la fonction debug
2012-12-26 Protection contre les inclusions infinies du fichier des defines
2012-12-26 Protection contre les inclusions infinies de la classe du GPS
2012-12-26 Protection contre les inclusions infinies de la classe du capteur de pression
2012-12-26 Protection contre les inclusions infinies de la classe du capteur de temperature
2012-12-26 Protection contre les inclusions infinies des fonctions ayant attrait a la trame
2012-12-26 Ajout de defines concernant le temps entre chaque refresh et entre chaque envoi
2012-12-26 Implementation d'une nouvelle méthode d'envoi, qui est universelle pour chaque capteur. comme ça ca fait un peu moins de code a maintenir et c'est plus pratique et c'est plus la classe (dans tout les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
2012-12-26 maj des shields
    [Shield FSK.brd, Shield FSK.sch]
2012-12-26 Ajout de la sortie seria a tous les capteur auxquels la classe sortie a deja été implémentée (Temperature et pression)
2012-12-26 maj du schématique du Shield FSK.
    [Shield FSK.sch]
2012-12-26 tri dans le dossier Electronique.
    [Carte Arduino.sch, shield_capteur.sch]
2012-12-27 j'avait pas fini d'implemter les nouvelles propriétés de la classe mère capteur, maintenant c'est bon !!
2012-12-27 Ajout de la version du Shield FSK de 'thelme.
    Ajout:
    Element de filtrage de l'alimentation:
    Condensateur autour du régulateur
    Self cms de filtrage.
    Diode anti "oups j'ai mis l'alim a l'envers"
    Led de Mise Sous Tension
    Bornier pour mettre une led de MST (hennn) visible de l'exterieur
    Grossisement des pistes d'alimentation
    Mise en place des deux potentiometres pour régler la fréquence
    Plan de masse
    [$savepcb.brd, fsk-alim10v-shield.brd, fsk-alim10v-shield.sch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]
2012-12-27 Codage de la classe pour la sortie par la carte SD
2012-12-29 Implementation de la classe mère dans le capteur d'humidité (ou l'inverse ...)
2012-12-29 Implementationde la classe mère dans le GPS (ou l'inverse ...)
2013-01-12 Réparation gestion des graphiques. A vérifier avec un arduino
2013-01-12 debut debogage Code arduino
2013-01-12 Gestion des coefficients
2013-01-19 legeres modifs et fix d'une fuite memoire
    [Arduino.ino, defines.h, gps.cpp, serial_out.cpp]
2013-01-19 L'editeur de chronologie est termine et fonctionnel Meme un peut plus enrobé que ce que je penssait faire ( dedicace a Mr Geledan ) Reste tout de meme quelques elements d'interface a amelliorer : - Q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
2013-01-26 Remplissage de l'administratif
    [Dossier_de_projet_2012-2013.xls]
2013-01-26 Complétion du dossier de projet. A faire checker par une autorité supérieure.
    [Dossier_de_projet_2012-2013.xls]
2013-01-26 J'ai bien avancé le widget lecteur - 2-3 choses a ameillorer - Pouvoir donner une heure de debut et de fin aux evenements - Adapter la barre de chargement en consequence
2013-01-26 derniers tweaks de l'administratif
    [Dossier_de_projet_2012-2013.xls]
2013-02-02 Gestion de la durée des évenements dans l'interface de l'éditeur de chronologie L'interface peut cependant être ameilloré
2013-02-02 Modifications de l'input dialog pour le port série
2013-02-02 Finition de l'editeur de chronologie Petit fail : j'avais oublié de gèrer le avant/après
2013-02-02 Fix de l'envoie série, mais la carte SD marche pas ...
    [Arduino.ino, Datalogger.ino, defines.h, gps.cpp, sd_out.cpp, serial_out.cpp]
2013-02-09 Fix de la sortie sur carte SD
    [Arduino.ino, Datalogger.ino, defines.h, sd_out.cpp, sd_out.h]
2013-02-15 Plus de bugs sur le lecteur de chronologie normalement
2013-02-15 J'avais aussi modifie ca --' Vive les commits en console ...
2013-02-15 Ajout de l'altitude pour le GPS
2013-02-16 Modification de l'envoi (pas de retour a la ligne)
2013-02-16 Boite de dialogue de selection du port
2013-02-16 Un peut de mise en page ... J'ai donné un minimum de classe à l'editeur de chronologie (franchement maintenant c'est vachement pimp) Chez moi quand je me ferais chier je fignolerais ptet en foutant d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
2013-02-16 modifs de la journée pour test nouveau shield sd
2013-02-23 Ajout du log dans la sql et debogage
2013-03-02 Calibration du capteur de pression et detection d'apogée
2013-03-07 Ajout de la doc des piles
2013-03-07 Ajout du capteur de pression exterieur
2013-03-08 Dépacement des fichiers de "TimeCalcs" Bah ouai, c'est pas grand chose, mais je voulais pas avoir ouvert Qt pour rien --' Et au passage j'ai viré le constructeur que QtCreator avait ajouté automatiqu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
2013-03-08 Ajout des executables + Approprissement du dossier ChonoEdit (oui, c'est une faute de frappe --') À votre demande générale
2013-03-08 Update de la liste des capteurs
2013-03-08 Modification des includes du logger suite au déplacement de "TimeCalcs"
2013-03-08 reel fix des includes
2013-03-23 Ajout de la modelisation solidworks de la nacelle
    [Arduino.SLDPRT, Assemblage Pile.SLDASM, Assemblage.SLDASM, Assemblage_kiwi.SLDASM, Bouchon.SLDPRT, Bouchon_kiwi.SLDPRT, Kiwi.SLDPRT, Plaque inférieure.SLDPRT]
2013-03-23 Modification partiel du dossier
    [Dossier_de_projet_2012-2013.xls]
2013-03-24 Ajout de cotes pour la réalisation
    [Assemblage Pile.SLDASM, Assemblage_kiwi.SLDASM, Plaque2.SLDPRT, Plaque2_kiwi.SLDPRT]
2013-04-06 Ajout de la courbe de pression
    [courbes_pression.ods]
2013-04-06 Tous le merdier de Lucas
    [Dossier_de_projet_2012-2013.xls]
2013-04-06 Ajout du calcul de la pression
    [Dossier_de_projet_2012-2013.xls, courbes_pression.ods]
2013-04-06 J'ai mis à jours les profils
    [Dossier_de_projet_2012-2013.xls]
2013-04-06 Repokulation du projet + Choix du serveur d'envoi des données
2013-04-06 Ajout des fichiers pour la prévision de la trajection du ballon.
2013-04-06 Réparation du probleme d'actualisation du tableau historique
    [tablemgr.cpp]
2013-04-07 Ajout de cotes pour la réalisation de la nacelle
    [Assemblage.SLDASM, Plaque latérale.SLDPRT, Plaque supérieure.SLDPRT]
2013-04-13 Un magnifique schema de l'avion ! Designed by Remi Dupre ; copulright RDD (Remi Dupre Developpement) Realized wither LibreOffice (MDR)
2013-04-13 Dan n'a pas travaillé, contrairement à moi. J'ai fait une magnifique gestion des données GPS. De rien.
2013-04-27 La mission a été complétée. Score += 42.
    Maintenant l'affichage de l'historique des données fonctionne.
    Ehhhh ouai.
2013-06-15 Reparation du bug graphique + choix de l'heure du lancement
    [FenPrincipale.cpp, FenPrincipale.h, defines.h]
2013-06-15 Normalement y'a plus de couilla dans le paté
2013-08-01 Ajout de l'affiche de récupération du ballon
2013-08-19 Correction de l'url sur l'affiche
