mjc-ermont/2011/(notices)

Notices in the files:
Programmation/Fragments de code/Accelerometre/Accelerometre.ino:
it under the terms of the MIT License.
